mrfixpl/front-cam-MQB-DIY/hardware development and research/20220816 - OEM buttons disassembled.jpg

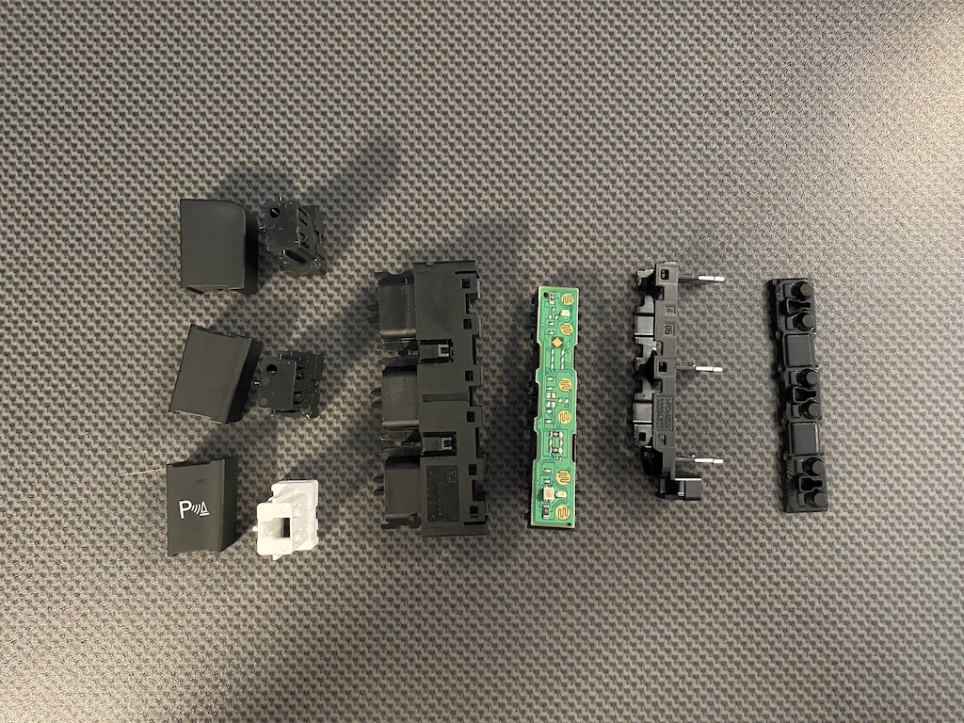
hardware development and research/20220816 - OEM buttons disassembled.jpg
