mrfixpl/front-cam-MQB-DIY/hardware development and research/20220823 - relay closeup.jpg

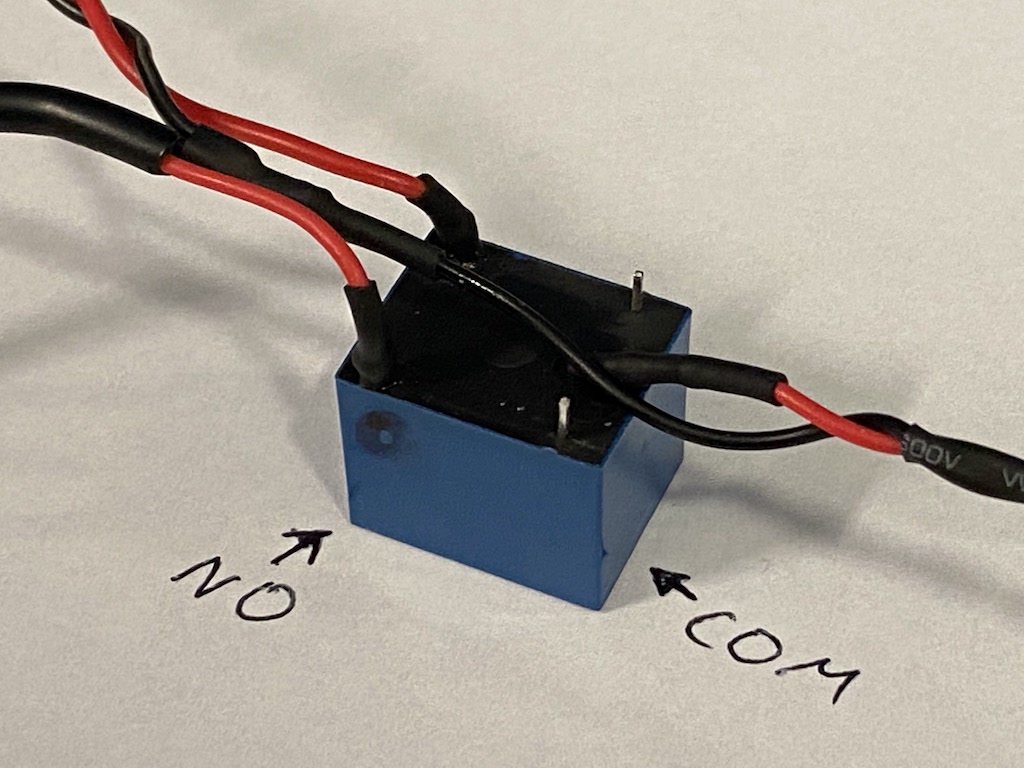
hardware development and research/20220823 - relay closeup.jpg
