mrfixpl/front-cam-MQB-DIY/hardware development and research/20220824 - relay ready.jpg

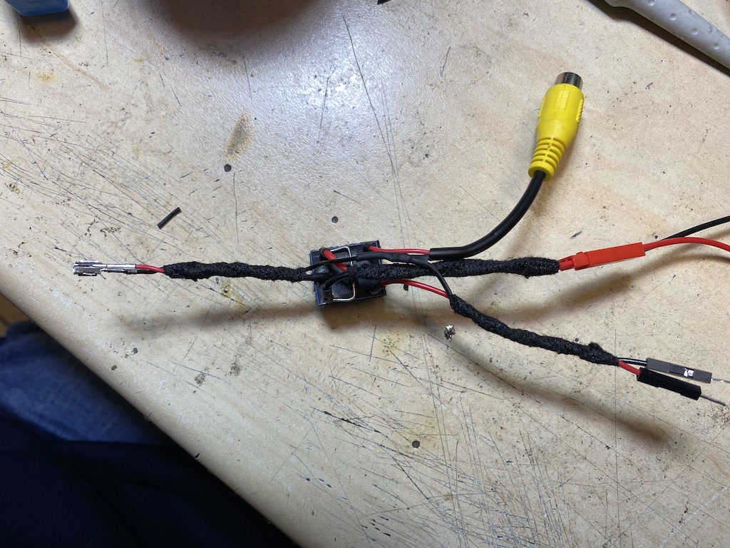
hardware development and research/20220824 - relay ready.jpg
