mrfixpl/front-cam-MQB-DIY/hardware development and research/20220814 - wiring diagram v1.jpg

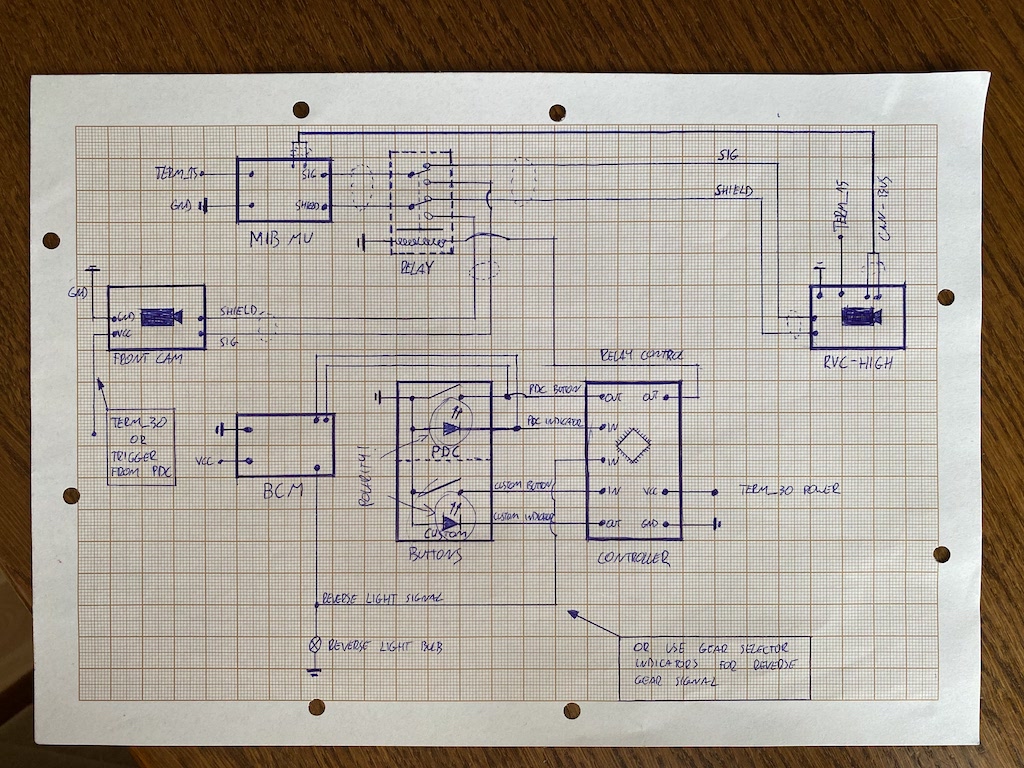
hardware development and research/20220814 - wiring diagram v1.jpg
