mrfixpl/front-cam-MQB-DIY/hardware development and research/20220816 - OEM LED indicator test.jpg

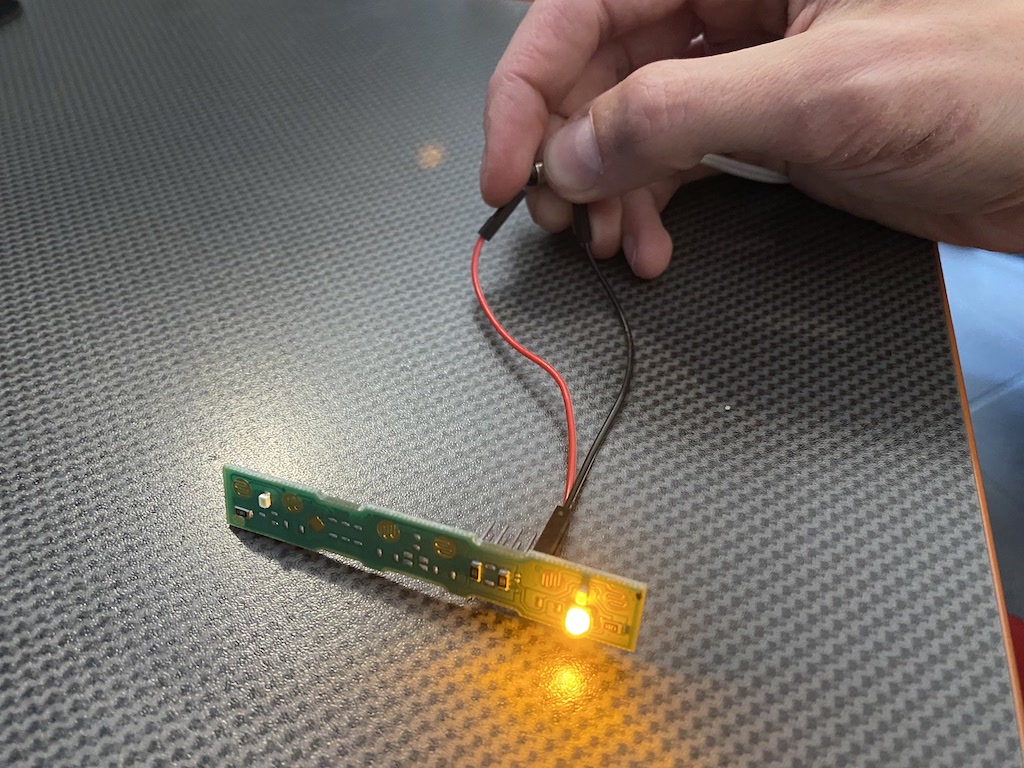
hardware development and research/20220816 - OEM LED indicator test.jpg
