mrfixpl/front-cam-MQB-DIY/hardware development and research/20220817 - custom button engraving test.jpg

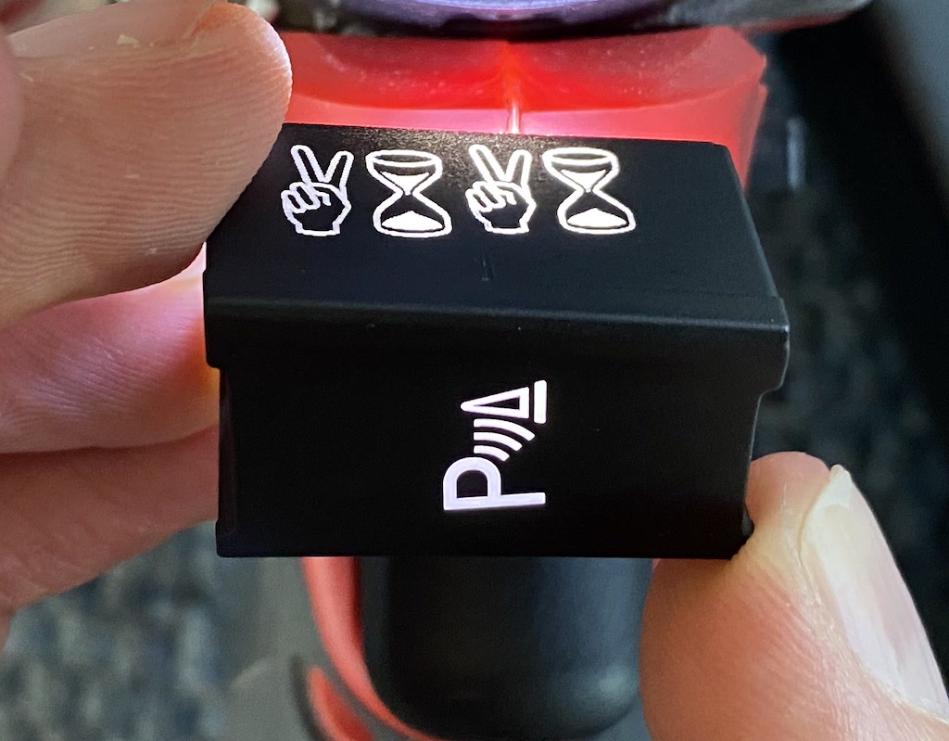
hardware development and research/20220817 - custom button engraving test.jpg
