mrfixpl/front-cam-MQB-DIY/(commit log)

2022-08-22 Basic handling of the additional button
2022-08-22 handling automatic front camera trigger
2022-08-22 Couple AliExpress links
2022-08-22 Feature to keep front cam off if it was switched off by user
2022-08-22 Linking OneButton library, couple readme changes
2022-08-24 couple comments
2022-08-26 relay pictures
2022-08-29 info about low-quality camera
2022-11-18 Best camera link, YT link
